metrosync/Embedded-Course-Design/验收报告.md

# 基于 STM32F103C8T6 的智能手表验收报告

> 课程设计题目：基于 STM32F103C8T6 的智能手表设计  
> 工程名称：SmartWatch_HAL_RTOS  
> 验收日期：2026 年 7 月 10 日  
> 学生姓名：聂善澄  
> 学号：3124009573  
> 指导教师：周贤中  
> 验收结论：已通过最终验收

## 1. 项目概述

本项目完成了一套基于 STM32F103C8T6 的智能手表原型系统。系统以 FreeRTOS 管理时间、传感器、蓝牙和界面等任务；使用 OLED 显示菜单、秒表、时钟、MPU6050 三轴加速度与步数；使用 EC11 旋转编码器完成菜单选择；通过 HC-05 蓝牙模块与手机串口助手同步步数和查询状态。

最终实物采用面包板搭建，供电方案为充电宝通过 USB 直接给开发板供电。项目未使用锂电池、充电保护模块和外壳，验收重点放在功能稳定性、交互效果和软硬件联调结果。

## 2. 验收内容与结果

| 验收项目 | 验收方法 | 验收结果 |
| --- | --- | --- |
| 系统上电与 OLED 显示 | 充电宝 USB 直接供电，观察系统上电后的 OLED 界面 | 通过；系统可稳定启动并显示菜单 |
| FreeRTOS 多任务运行 | 连续运行并切换各功能页面 | 通过；时间、显示、传感器与蓝牙功能可并行工作 |
| 旋转编码器菜单 | 旋转编码器移动光标，按下编码器键确认，按返回键退出功能页 | 通过；四项菜单同页显示，箭头光标局部移动，无整屏闪烁 |
| 秒表 | 菜单进入秒表页，启动、暂停和清零 | 通过；秒表状态与计时显示正常 |
| 软件时钟 | 进入时钟页，执行时间显示与手动调整 | 通过；时、分、秒显示和调节正常 |
| MPU6050 数据读取 | 进入传感器页，观察 AX、AY、AZ 数据变化 | 通过；模块识别正常，三轴加速度数据可实时显示 |
| 计步功能 | 携带或摆动原型进行步数测试，与人工计数对照 | 通过；本次验收测试准确度约 90% |
| 蓝牙步数查询 | 手机连接 HC-05，发送 `S` 查询命令 | 通过；手机端可接收步数等状态数据 |
| 蓝牙自动上报 | 步数增加时观察手机串口助手 | 通过；手机端自动收到 `Steps: n` 步数记录 |
| 蓝牙清零 | 手机发送 `C` 命令 | 通过；系统返回确认信息并清零步数 |

## 3. 实物与功能展示

### 3.1 系统总装与菜单

智能手表原型总装与四项菜单

图 1 原型采用 STM32 开发板、OLED、EC11 编码器和面包板搭建。菜单包含 Stopwatch、Clock、MPU6050、Steps 四项，旋转编码器移动箭头光标，按压选择功能。

系统整体连接与充电宝供电

图 2 系统整体连接。验收时由充电宝通过 USB 直接供电，未使用锂电池。

### 3.2 显示与传感器功能

| 功能 | 实物照片 | 说明 |
| --- | --- | --- |
| 计步页面 | 计步页面 | 显示累计步数、运动强度和当前状态。 |
| MPU6050 页面 | MPU6050数据页面 | `MPU6050 OK`，并实时显示 AX、AY、AZ。 |
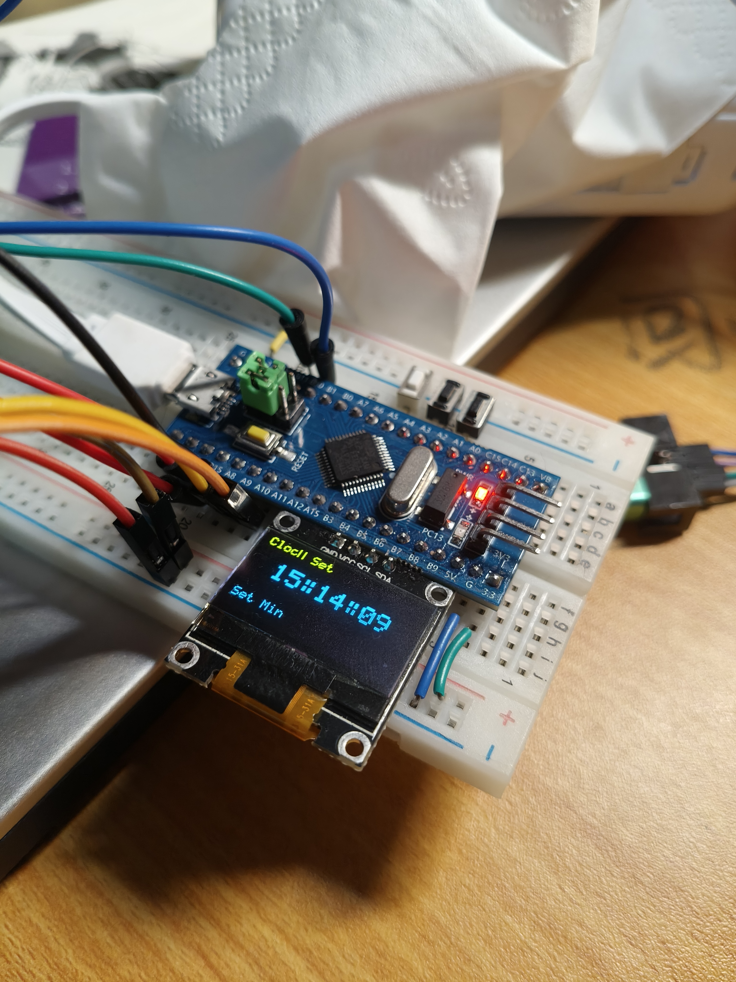
[picture p1: image/微信图片_20260710180112_124_37.jpg]
时钟设置页面
| 时钟页面 |  | 显示时钟并支持进入设置状态。 |
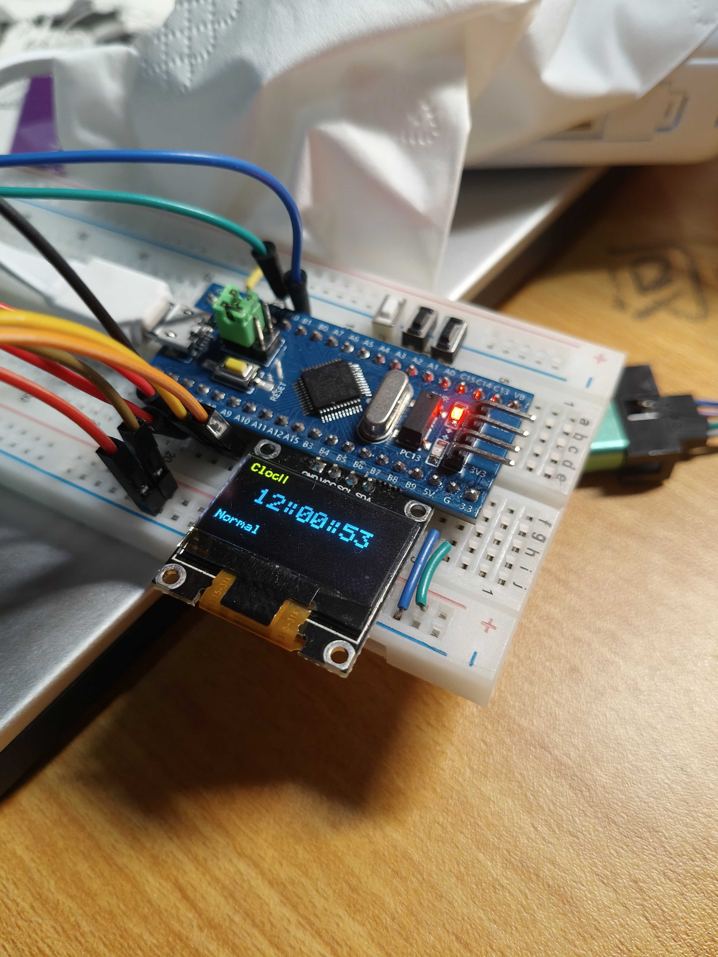
[picture p2: image/微信图片_20260710180113_125_37.jpg]
时钟正常显示
| 正常时钟显示 |  | 以大字体显示时、分、秒。 |
| 秒表页面 | 秒表页面 | 显示秒表计时和运行状态。 |

### 3.3 蓝牙通信功能

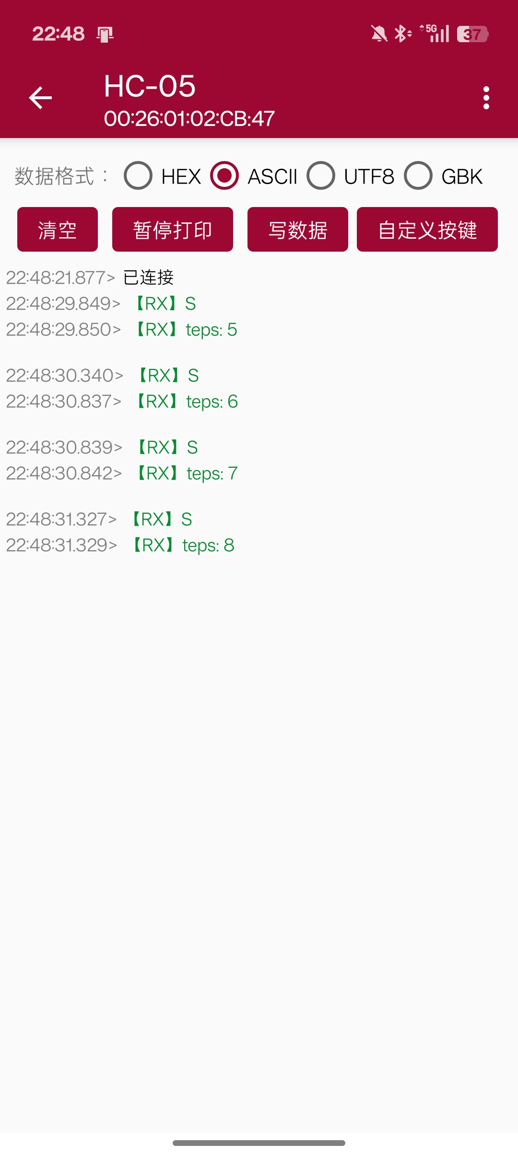
[picture p3: image/微信图片_20260710175924_121_37.jpg]
HC-05 手机串口助手步数记录


图 3 手机已连接 HC-05。发送 `S` 后可读取步数；步数由 5 递增至 8 时，手机端收到自动上报的 `Steps` 数据，证明蓝牙同步链路工作正常。

## 4. 创新点与特色

### 4.1 面向小屏幕的编码器菜单交互

系统没有将编码器仅用于翻页，而是实现了“旋转移动光标、按下选择、按键返回”的菜单操作。四个功能项统一放置在同一页，光标采用小箭头显示；光标移动时仅擦除和重绘两行箭头，不进行整屏刷新，减少 OLED 闪烁并提高操作连贯性。

### 4.2 FreeRTOS 多任务与显示局部刷新结合

时间维护、传感器采样、蓝牙通信和界面交互被拆分为独立任务。界面仅在数据变化时刷新相关区域，使传感器数据、步数和蓝牙通信可以同时运行，同时避免全屏重复清除带来的可见闪烁。

### 4.3 计步数据的本地显示与无线同步

项目将 MPU6050 加速度数据用于阈值式计步，并将结果同时呈现在 OLED 和手机端。手机既能发送命令查询或清零步数，也能在步数变化时自动接收更新。本次验收测试中，计步准确度约为 90%，满足课程设计原型的演示需求。

### 4.4 低门槛、可复现的供电与展示方案

最终采用充电宝 USB 直接供电，规避了锂电池充电、保护和稳压电路在短周期课程设计中可能引入的安全与调试风险。该方案便于现场验收和长期演示，且保持了系统供电稳定。

## 5. 关键实现说明

### 5.1 硬件连接

| 模块 | STM32 接口 | 说明 |
| --- | --- | --- |
| OLED | PB6 / PB7 | 软件 I2C，显示菜单和各功能页面 |
| MPU6050 | PB10 / PB11 | I2C2，读取三轴加速度数据 |
| HC-05 | PA9 / PA10 | USART1，9600 bps 蓝牙通信 |
| EC11 编码器 A/B | PB15 / PB14 | GPIO 上拉输入，读取旋转方向 |
| EC11 编码器按键 | PA8 | GPIO 上拉输入，低电平有效 |
| 返回、清零等按键 | PA1 / PA3 | GPIO 上拉输入 |

### 5.2 软件任务

| 任务 | 主要职责 |
| --- | --- |
| 时间任务 | 维护系统运行时间、软件时钟与秒表时间 |
| 传感器任务 | 初始化并读取 MPU6050，更新加速度和步数 |
| 蓝牙任务 | 处理查询、清零命令，步数变化时自动发送数据 |
| 界面任务 | 处理按键和编码器，绘制菜单与各功能页面 |

## 6. 验收结论与后续改进

系统已完成题目基本要求，并完成旋转编码器菜单、HC-05 蓝牙同步和 MPU6050 计步三项扩展功能。最终实物经充电宝供电后运行稳定，已顺利通过验收。

现阶段原型的主要不足是未制作 PCB 和外壳，计步算法仍为阈值法。后续可在不改变现有软件结构的基础上增加滤波、动态阈值、数据存储和低功耗电池供电模块，并将面包板连接转为 PCB 或洞洞板固定连接。
