metrosync/Embedded-Course-Design/中期检查报告.md

# 基于 STM32F103C8T6 的智能手表中期检查报告

> 课程设计题目：基于 STM32F103C8T6 的智能手表设计  
> 工程名称：SmartWatch_HAL_RTOS  
> 开发环境：STM32CubeIDE + HAL 库 + FreeRTOS CMSIS_V1  
> 检查时间：2026 年 7 月 6 日 15:00  
> 学生姓名：聂善澄  
> 学号：3124009573  
> 指导教师：周贤中  

## 1. 项目概述

本项目设计并实现一套基于 STM32F103C8T6 的智能手表原型系统。系统以 STM32F103C8T6 为主控，使用 FreeRTOS 进行任务调度，通过 OLED 显示菜单、秒表、时钟、MPU6050 数据和步数信息；通过旋转编码器完成菜单光标移动和功能选择；通过 HC-05 蓝牙模块与手机串口助手进行数据同步；通过 MPU6050 加速度数据实现简易计步。

本阶段采用面包板和杜邦线完成硬件连接，不制作 PCB 和外壳。当前工作重点是保证系统能够稳定上电、稳定显示、稳定响应输入，并能完成中期检查所需的核心功能演示。

## 2. 物料到位总览

### 2.1 已到位物料

| 物料名称 | 型号/规格 | 数量 | 当前状态 | 用途 |
| --- | --- | ---: | --- | --- |
| STM32 开发板 | STM32F103C8T6 | 1 | 已到位，已用于烧录和调试 | 主控平台 |
| OLED 显示屏 | SSD1306 I2C OLED | 1 | 已到位，显示正常 | 菜单、时间、传感器、步数显示 |
| 面包板 | 常规实验面包板 | 1 | 已到位 | 模块连接和现场展示 |
| 杜邦线 | 公对公/公对母 | 若干 | 已到位 | 模块连线 |
| 独立按键 | 普通轻触按键 | 3 | 已到位，输入正常 | 返回、清零、辅助操作 |
| 旋转编码器 | EC11，带按压开关 | 1 | 已到位，A/B/KEY 已调通 | 菜单切换与确认选择 |
| MPU6050 模块 | GY-521/MPU6050 | 1 | 已到位，I2C 读取正常 | 加速度采集与计步 |
| HC-05 蓝牙模块 | 串口蓝牙模块 | 1 | 已到位，通信已调通 | 手机端查询和步数上报 |
| USB 数据线/下载线 | USB | 1 | 已到位 | 供电、烧录、调试 |

### 2.2 未到位或暂不接入物料

| 物料名称 | 当前处理 | 原因 |
| --- | --- | --- |
| 锂电池、TP4056、3.3V 稳压模块 | 暂不作为中期主线 | 当前优先保证 USB 供电下系统稳定，避免电池供电引入额外不确定因素 |
| PCB 或洞洞板 | 暂不制作 | 课程周期较短，当前以面包板完成功能验证和现场演示 |
| 外壳、表带 | 暂不制作 | 本阶段重点是嵌入式功能完整性，不以外观封装作为主线 |
| 蜂鸣器或震动马达 | 暂不接入 | 属于附加展示功能，不影响当前基本要求和主要扩展要求 |

## 3. 当前完成进度

### 3.1 已完成工作

| 模块 | 完成情况 | 说明 |
| --- | --- | --- |
| STM32CubeIDE 工程 | 已完成 | 工程可编译、可生成 `SmartWatch_HAL_RTOS.elf` |
| FreeRTOS 配置 | 已完成 | 已建立默认任务、时钟任务、传感器任务、蓝牙任务、UI 任务 |
| OLED 初始化与显示 | 已完成 | 已解决 RTOS 启动后黑屏问题，OLED 可正常显示菜单和各功能页 |
| 菜单界面 | 已完成 | 当前为 4 个选项同屏显示，旋转编码器移动小箭头光标，按下选择 |
| 秒表功能 | 已完成 | 支持启动、暂停和清零 |
| 时钟功能 | 已完成 | 支持时间显示和手动调时 |
| MPU6050 数据读取 | 已完成 | 可读取并显示 AX、AY、AZ 三轴加速度原始数据 |
| 简易计步 | 已完成基础版本 | 可根据加速度变化触发步数增加，并在 OLED 显示 |
| 蓝牙通信 | 已完成基础版本 | 支持步数查询、清零命令和步数变化自动上报 |
| 编码器输入 | 已完成 | A 相接 PB15，B 相接 PB14，按压 KEY 接 PA8，输入为上拉、低电平有效 |
| OLED 局部刷新 | 已完成 | 菜单光标移动时只刷新光标区域，减少整屏闪烁 |

### 3.2 进行中工作

| 工作项 | 当前状态 | 后续处理 |
| --- | --- | --- |
| 计步阈值优化 | 基础可用，但准确度仍有限 | 继续根据实测动作调整高低阈值和冷却时间 |
| 接线固定 | 功能调通，机械稳定性仍需加强 | 中期检查前固定关键杜邦线，减少接触不良 |
| 演示流程整理 | 已具备功能基础 | 准备固定演示顺序：菜单、秒表、时钟、MPU6050、计步、蓝牙 |
| 测试记录补充 | 已有编译和功能调试记录 | 补充现场照片、手机蓝牙接收截图和最终测试表 |

### 3.3 未开始或暂缓工作

| 工作项 | 状态 | 说明 |
| --- | --- | --- |
| PCB 设计与打样 | 暂缓 | 不作为当前课程主线 |
| 电池供电演示 | 暂缓 | 当前使用 USB 稳定供电，更适合中期展示 |
| 外壳封装 | 暂缓 | 功能验证优先 |
| 手机专用上位机 | 暂缓 | 当前使用手机串口助手完成蓝牙展示 |

## 4. 硬件调试情况

### 4.1 主控与供电

STM32F103C8T6 开发板目前通过 USB 供电和烧录。系统上电后能够进入 FreeRTOS 调度，OLED 能够显示菜单界面。此前调试中出现过屏幕黑屏问题，定位后将 OLED 初始化放到 RTOS 启动前执行，并调整 FreeRTOS 堆大小，系统恢复正常。

当前结果：

- 程序可正常烧录。
- 上电后 OLED 有稳定显示。
- FreeRTOS 多任务能够正常创建和运行。
- 当前优先使用 USB 供电，未引入电池供电链路。

### 4.2 OLED 显示模块

OLED 使用 PB6/PB7 模拟 I2C 驱动，当前已完成字符显示、数字显示和大字体时间显示。菜单页显示 4 个功能项：Stopwatch、Clock、MPU6050、Steps。光标采用 `->` 小箭头，并通过局部刷新移动光标，避免每次旋转编码器都整屏清屏。

已解决问题：

| 问题 | 原因判断 | 解决措施 | 当前状态 |
| --- | --- | --- | --- |
| 烧录后屏幕黑屏 | OLED 初始化时序与 RTOS 任务启动关系不稳定 | 将 OLED 初始化前移到 RTOS 启动前 | 已解决 |
| 菜单四行拥挤 | OLED 页高有限，原布局不利于观察 | 调整菜单行距和光标形式 | 已解决 |
| 光标移动闪屏 | 每次移动都整屏刷新 | 改为只刷新旧光标和新光标位置 | 已解决 |

### 4.3 旋转编码器与按键

旋转编码器当前接线如下：

| 编码器端子 | STM32 引脚 | GPIO 配置 | 说明 |
| --- | --- | --- | --- |
| A | PB15 | GPIO 输入，上拉 | 编码器 A 相 |
| B | PB14 | GPIO 输入，上拉 | 编码器 B 相 |
| C | GND | 接地 | 公共端 |
| KEY | PA8 | GPIO 输入，上拉 | 按压确认 |
| GND | GND | 接地 | 模块地 |

当前功能：

- 在菜单页旋转编码器可移动光标。
- 按下编码器进入所选功能页。
- 编码器灵敏度已降低，当前累计 4 个有效跳变才移动一次光标，避免过度灵敏。
- PA1 保留为从功能页返回菜单的按键。

### 4.4 MPU6050 模块

MPU6050 使用 I2C2 连接，SCL 接 PB10，SDA 接 PB11。系统通过读取 `WHO_AM_I` 判断模块在线状态，并周期读取三轴加速度数据。

当前结果：

- MPU6050 页面可显示模块状态。
- AX、AY、AZ 数据可随模块姿态和运动变化。
- 计步页面可根据运动强度触发步数增加。

当前限制：

- 计步算法仍为阈值法，适合课程展示，但不是高精度计步算法。
- 面包板接线和手持姿态会影响计步稳定性。

### 4.5 HC-05 蓝牙模块

HC-05 使用 USART1 通信，PA9 为 TX，PA10 为 RX，波特率为 9600 bps。当前手机串口助手可连接模块并收发文本命令。

当前协议：

| 手机端命令 | STM32 响应 | 功能 |
| --- | --- | --- |
| `S` 或 `s` | 返回步数、时间和传感器状态 | 查询当前状态 |
| `C` 或 `c` | 返回清零确认 | 清零步数 |
| 步数增加 | 自动发送 `Steps: n` | 自动同步步数 |

已解决问题：

- 蓝牙初期出现步数查询和自动发送失效，后续检查串口配置并将 USART1 波特率调整为 9600 后恢复。
- 当前蓝牙可用于中期检查的手机端演示。

## 5. 软件调试情况

### 5.1 FreeRTOS 任务划分

| 任务名称 | 主要职责 | 当前状态 |
| --- | --- | --- |
| defaultTask | 保留 CubeMX 默认任务 | 正常 |
| clockTask | 维护系统运行时间、秒表时间和软件时钟 | 正常 |
| sensorTask | 初始化并读取 MPU6050，更新计步数据 | 正常 |
| bluetoothTask | 处理 HC-05 接收命令和自动上报 | 正常 |
| uiTask | OLED 页面显示、按键和编码器输入处理 | 正常 |

当前任务划分已经能够支撑多功能并行运行。UI 任务负责交互响应，传感器任务负责采样，蓝牙任务负责通信，避免所有逻辑堆在一个主循环中。

### 5.2 页面与交互逻辑

当前 OLED 页面结构如下：

| 页面编号 | 页面名称 | 进入方式 | 显示内容 |
| ---: | --- | --- | --- |
| 0 | 菜单页 | 上电默认进入，PA1 从功能页返回 | Stopwatch、Clock、MPU6050、Steps |
| 1 | 秒表页 | 菜单选择 Stopwatch | 秒表时间、运行/暂停状态 |
| 2 | 时钟页 | 菜单选择 Clock | 当前时间、调时状态 |
| 3 | MPU6050 页 | 菜单选择 MPU6050 | 模块状态、三轴加速度 |
| 4 | 计步页 | 菜单选择 Steps | 步数、运动强度、触发状态 |

菜单调试结果：

- 四个功能项尽量放在同一页。
- 光标为小箭头。
- 旋转移动光标，按下选择。
- 光标移动只更新光标区域，不整屏刷新。

### 5.3 已通过的软件测试用例

| 测试项目 | 测试方法 | 预期结果 | 当前结果 |
| --- | --- | --- | --- |
| 工程编译 | 使用 STM32CubeIDE 工具链构建 Debug 工程 | 生成 `.elf` 文件 | 已通过 |
| OLED 上电显示 | 烧录后观察 OLED | 出现菜单页面 | 已通过 |
| 菜单光标移动 | 旋转编码器 | 小箭头上下移动 | 已通过 |
| 菜单选择 | 按下编码器 KEY | 进入对应功能页 | 已通过 |
| 返回菜单 | 在功能页按 PA1 | 返回菜单页 | 已通过 |
| 秒表启动暂停 | 进入秒表页后按确认键 | 秒表运行/暂停切换 | 已通过 |
| 秒表清零 | 秒表页按清零键 | 时间归零 | 已通过 |
| 时钟调节 | 进入时钟页后切换调时模式 | 可调整时间字段 | 已通过 |
| MPU6050 数据显示 | 进入 MPU6050 页并晃动模块 | 三轴数据变化 | 已通过 |
| 计步触发 | 晃动模块或模拟步行动作 | 步数增加 | 已通过基础测试 |
| 蓝牙查询 | 手机串口助手发送 `S` | 返回当前状态 | 已通过 |
| 蓝牙清零 | 手机串口助手发送 `C` | 步数清零并返回确认 | 已通过 |
| 蓝牙自动上报 | 步数增加 | 手机端收到 `Steps: n` | 已通过 |

### 5.4 当前编译结果

最近一次 Debug 构建已经通过，生成文件为：

```text
project/SmartWatch_HAL_RTOS/Debug/SmartWatch_HAL_RTOS.elf
```

最近一次构建资源占用如下：

```text
text: 28468
data: 40
bss: 6976
total: 35484
```

FreeRTOS 堆大小已经调整为 4096 bytes，当前任务创建和系统运行正常。

## 6. 存在的问题与风险

| 问题或风险 | 影响 | 当前判断 | 应对方案 |
| --- | --- | --- | --- |
| 面包板和杜邦线接触不稳定 | 现场演示时可能掉线、复位或模块无响应 | 当前最大硬件风险 | 检查电源线和 I2C 线，缩短关键连线，中期检查前固定线路 |
| 计步算法准确度有限 | 步数可能受手持姿态和晃动幅度影响 | 不影响展示，但不适合作为精确计量 | 保持“简易计步”定位，继续调阈值，演示时采用固定动作 |
| 蓝牙手机端显示可能分包 | 手机串口助手可能把一条消息拆成多行 | 数据本身未丢失 | 使用短文本协议，演示前清空接收区 |
| OLED 字体资源有限 | 中文菜单显示困难 | 当前使用英文菜单规避 | 保持英文菜单，保证显示清晰 |
| 电池供电未接入 | 不能展示完整手表移动供电形态 | 中期不作为主线 | 验收前视时间决定是否接入，优先保证 USB 供电稳定 |
| FreeRTOS 资源余量有限 | 后续继续加功能可能导致堆或栈不足 | 当前已能稳定运行 | 不再盲目增加任务，后续只做必要优化和测试记录 |

## 7. 后续工作计划

| 时间 | 工作内容 | 目标 |
| --- | --- | --- |
| 7 月 6 日前 | 固定接线，整理中期检查演示顺序 | 保证现场演示稳定 |
| 7 月 6 日中期检查 | 演示 OLED 菜单、秒表、时钟、MPU6050、计步和蓝牙通信 | 证明当前功能完成度 |
| 7 月 7 日 | 根据中期检查意见修正问题 | 消除现场暴露的故障点 |
| 7 月 8 日 | 补充测试截图、蓝牙接收记录和演示视频 | 为第一次验收准备材料 |
| 7 月 9 日第一次验收 | 完成功能演示，记录教师意见 | 形成修改清单 |
| 7 月 10 日第二次验收前 | 优化计步阈值、接线稳定性和答辩说明 | 提高最终展示稳定性 |
| 验收后一周内 | 完成个人总结报告 | 汇总设计、实现、测试与反思 |

## 8. 分工说明

本项目由本人单人完成，因此不存在组内重新分工。当前个人工作覆盖：

- 硬件连接：STM32、OLED、MPU6050、HC-05、按键、旋转编码器。
- 软件开发：FreeRTOS 任务划分、OLED 页面、菜单交互、计时、计步、蓝牙通信。
- 测试调试：烧录、黑屏问题排查、编码器灵敏度调整、蓝牙通信恢复、菜单刷新优化。
- 文档整理：计划书、系统设计文档、中期检查报告及后续总结材料。

## 9. 中期结论

截至中期检查前，项目已经完成智能手表原型的主要功能：OLED 显示、FreeRTOS 多任务运行、秒表、时钟、MPU6050 数据读取、简易计步、旋转编码器菜单控制和 HC-05 蓝牙数据同步。当前系统可以通过菜单完成主要功能切换，并具备现场演示条件。

后续工作不再以增加新模块为主，而应集中在三个方向：第一，固定硬件接线，降低现场故障风险；第二，继续微调计步阈值和编码器手感，使演示更顺畅；第三，补全测试照片、蓝牙接收记录和演示视频，为 7 月 9 日和 7 月 10 日验收做准备。
