metrosync/Embedded-Course-Design/STM32智能手表课设采购清单.md

# STM32 智能手表课设采购清单

> 由原 Excel 文件转换为 Markdown，便于 GitHub 直接预览和后续维护。

## 采购清单

| STM32 智能手表课设采购清单 |  |  |  |  |  |  |  |  |  |
| --- | --- | --- | --- | --- | --- | --- | --- | --- | --- |
| 路线：STM32F103C8T6 + OLED + FreeRTOS + 菜单输入 + 蓝牙/传感器展示。 |  |  |  |  |  |  |  |  |  |
| 类别 | 物料名称 | 规格/型号建议 | 数量 | 估算单价 | 估算小计 | 是否已有 | 采购优先级 | 购买建议 | 用途/判断 |
| 已拥有 | STM32F103C8T6 开发板 | 最小系统板/开发板均可 | 1 | 0 | 0 | 是 | 无需购买 | 保留 | 主控平台，当前工程已经按 STM32F103C8T6 + HAL + FreeRTOS 配置 |
| 已拥有 | 面包板 | 常规实验面包板 | 1 | 0 | 0 | 是 | 无需购买 | 保留 | 前期插线调试使用 |
| 已拥有 | 杜邦线 | 公对公、公对母、母对母按实际余量补 | 1 | 0 | 0 | 是 | 检查余量 | 保留 | OLED、蓝牙、编码器和传感器连接 |
| 已拥有 | OLED 屏 | SSD1306，I2C 接口，0.96/1.3 寸均可 | 1 | 0 | 0 | 是 | 无需购买 | 保留 | 当前代码已经写入 OLED 显示任务 |
| 第一优先 | EC11 旋转编码器 | 立插，20mm 梅花柄，20 定位，20 反脉冲，带按压开关 | 2 | 3 | 6 | 否 | 必买 | 买 | 菜单选择和按下确认；买 2 只，一只使用一只备用 |
| 第一优先 | HC-05 蓝牙模块 | 带底板焊排针，兼容版即可，1 个 | 1 | 34.3 | 34.3 | 否 | 必买 | 买 | 串口蓝牙通信展示；比 HC-06 更适合答辩说明 |
| 第一优先 | 电阻包 | 1/4W 金属膜，1%，常用阻值；重点含 220Ω、330Ω、1kΩ、4.7kΩ、10kΩ、100kΩ | 1 | 10 | 10 | 否 | 必买 | 买 | 限流、上拉/下拉、临时保护和调试备用 |
| 第一优先 | 电容包 | 瓷片/独石 + 电解常用包；重点含 100nF、1uF、10uF、47uF、100uF | 1 | 12 | 12 | 否 | 必买 | 买 | 电源滤波、模块旁路和供电缓冲 |
| 第一优先 | 轻触按键/按键模块 | 独立按键或小模块，至少 3 个，建议 5 个 | 5 | 0.8 | 4 | 否 | 必买 | 买 | 返回、确认、复位、备用输入；即使 EC11 带按压也建议留备用 |
| 第二优先 | MPU6050 模块 | GY-521/MPU6050，I2C 接口，带排针更省事 | 1 | 8 | 8 | 否 | 建议买 | 买 | 加速度/姿态/计步展示，作为智能手表传感器卖点 |
| 第二优先 | 有源蜂鸣器 | 3.3V/5V 小型有源蜂鸣器模块优先 | 1 | 3 | 3 | 否 | 建议买 | 买 | 闹钟、提醒、按键反馈，代码复杂度低 |
| 第二优先 | USB-TTL 模块 | CH340/CP2102，支持 3.3V TTL | 1 | 12 | 12 | 否 | 按需购买 | 看情况 | 调试 HC-05 AT 指令和串口输出；若开发板已有稳定串口工具可暂缓 |
| 第二优先 | 洞洞板/万能板 | 小尺寸即可，配合排针使用 | 2 | 5 | 10 | 否 | 建议买 | 买 | 最终展示比面包板更稳，适合把模块固定起来 |
| 第二优先 | 热缩管/绝缘胶带 | 小卷即可 | 1 | 6 | 6 | 否 | 建议买 | 买 | 防短路、固定线束、提升展示可靠性 |
| 备用 | 备用 OLED 屏 | I2C 接口，和现有屏兼容 | 1 | 15 | 15 | 否 | 可选 | 预算足再买 | OLED 接错线较容易损坏；预算紧张可不买 |
| 备用 | 备用杜邦线 | 10cm/20cm 混合买 | 1 | 6 | 6 | 是 | 可选 | 看余量 | 若现有线不够或接触不良，再补 |
| 暂缓 | TP4056 Type-C 充电保护模块 | 带保护板版本 | 1 | 5 | 5 | 否 | 暂缓 | 先不买 | 只有做锂电池供电时才需要；当前主线是桌面演示 |
| 暂缓 | 3.7V 锂电池 | 302530/402030 等小容量电池 | 1 | 15 | 15 | 否 | 暂缓 | 先不买 | 电池供电会引入充电、安全和稳压问题，暂不抢主线 |
| 暂缓 | 3.3V 稳压模块 | ME6211/HT7333/MCP1700 等低压差稳压 | 1 | 5 | 5 | 否 | 暂缓 | 先不买 | 只有脱离开发板和 USB 供电时才需要 |
| 暂缓 | 1N4148 开关二极管 | 小信号高速二极管，常用包可含 | 1 | 3 | 3 | 否 | 不单买 | 不买 | 当前不是自制电源板或保护电路，单独购买意义不大 |
| 暂缓 | 手表表带/外壳材料 | 亚克力、3D 打印或表带材料 | 1 | 20 | 20 | 否 | 暂缓 | 先不买 | 开发板尺寸不像手表，答辩重点先放在功能完整性 |

## 预算汇总

| 预算汇总 |  |  |  |  |  |
| --- | --- | --- | --- | --- | --- |
| 采购口径 | 估算金额 | 包含类别 | 结论 | 说明 | 下一步动作 |
| 第一优先必买 | 66.3 | 第一优先 | 今天可以下单 | EC11、HC-05、阻容包、按键是当前最能降低调试风险的物料 | 先买 |
| 第一 + 第二优先建议买 | 93.3 | 第一优先 + 第二优先 | 更适合冲优秀 | 加入 MPU6050、蜂鸣器、洞洞板后，展示内容更完整 | 建议买 |
| 含备用 | 114.3 | 第一优先 + 第二优先 + 备用 | 预算充足再加 | 备用 OLED 和线材用于降低损坏或接触不良风险 | 按预算决定 |
| 暂缓部分 | 48 | 暂缓 | 当前不买 | 电池、电源保护、外壳属于后期包装，不宜过早占用精力 | 先不买 |
| 推荐实际下单 | 93.3 | 第一优先 + 第二优先中建议买项 | 主线方案 | 控制成本，同时保留答辩展示点 | 按清单筛选“买” |

## 来源与判断

| 来源与判断 |  |  |  |
| --- | --- | --- | --- |
| 项目 | 来源/依据 | 链接或说明 | 采用方式 |
| HC-05 蓝牙模块 | 用户商品截图 + 京东价格/型号页 | https://www.jd.com/jiage/140652e5bd854338fc6d6.html | 选带底板焊排针版本，按截图 ¥34.3 记入 |
| EC11 旋转编码器 | 用户前序确认 + 京东/Soundwell 型号页 | https://www.soundwell-cn.com/EC11sujiaozhouxilie/434.html | 选立插 20mm 梅花柄、20 定位、20 反脉冲、带按压开关，买 2 只 |
| MPU6050/GY-521 | 常见模块规格页 | https://www.amazon.com/HiLetgo-MPU-6050-Accelerometer-Gyroscope-Converter/dp/B078SS8NQV | 作为传感器扩展展示，放第二优先 |
| HC-05 接线与电气注意 | HC-05 模块说明页 | https://www.sdmodel.com.tw/content.php?cn=item&start=0&tid=477 | 提醒使用带底板版本，注意 VCC/GND/TXD/RXD |
| 1N4148 | 当前项目边界判断 | 不做自制电源保护板，暂不单买 | 从主采购清单中降为暂缓 |
| 电阻电容包 | 当前电路调试需要 | 重点阻值：220Ω、330Ω、1kΩ、4.7kΩ、10kΩ、100kΩ；重点电容：100nF、1uF、10uF、47uF、100uF | 用于上拉、限流、滤波和临时修补 |
| 课程要求 | 本地 README 与当前工程状态 | E:/Embedded Course Design/README.md；SmartWatch_HAL_RTOS 已能编译 | 清单围绕能展示、能答辩收敛 |
