metrosync/Embedded-Course-Design/Core/Inc/main.h

#define KEY_UP_Pin GPIO_PIN_3
#define KEY_UP_GPIO_Port GPIOA
#define KEY_OK_Pin GPIO_PIN_5
#define KEY_OK_GPIO_Port GPIOA
#define ENC_KEY_Pin GPIO_PIN_8
#define ENC_KEY_GPIO_Port GPIOA
#define ENC_B_Pin GPIO_PIN_14
#define ENC_B_GPIO_Port GPIOB
#define ENC_A_Pin GPIO_PIN_15
#define ENC_A_GPIO_Port GPIOB
#define KEY_NEXT_Pin GPIO_PIN_1
#define KEY_NEXT_GPIO_Port GPIOA
#define ENC_KEY_Pin GPIO_PIN_8
#define ENC_KEY_GPIO_Port GPIOA
#define ENC_A_Pin GPIO_PIN_15
#define ENC_A_GPIO_Port GPIOB
#define ENC_B_Pin GPIO_PIN_14
#define ENC_B_GPIO_Port GPIOB
