metrosync/Embedded-Course-Design/Core/Inc/mpu6050.h

#ifndef MPU6050_H
#define MPU6050_H

#include "main.h"
#include <stdint.h>

typedef struct {
  int16_t ax;
  int16_t ay;
  int16_t az;
  int16_t temp;
  int16_t gx;
  int16_t gy;
  int16_t gz;
} MPU6050_Data;

uint8_t MPU6050_Init(void);
uint8_t MPU6050_ReadWhoAmI(uint8_t *id);
uint8_t MPU6050_ReadData(MPU6050_Data *data);

#endif
